vinb7/pulsed_laser_intensity_stabilization/AOM/aom_explanation.png

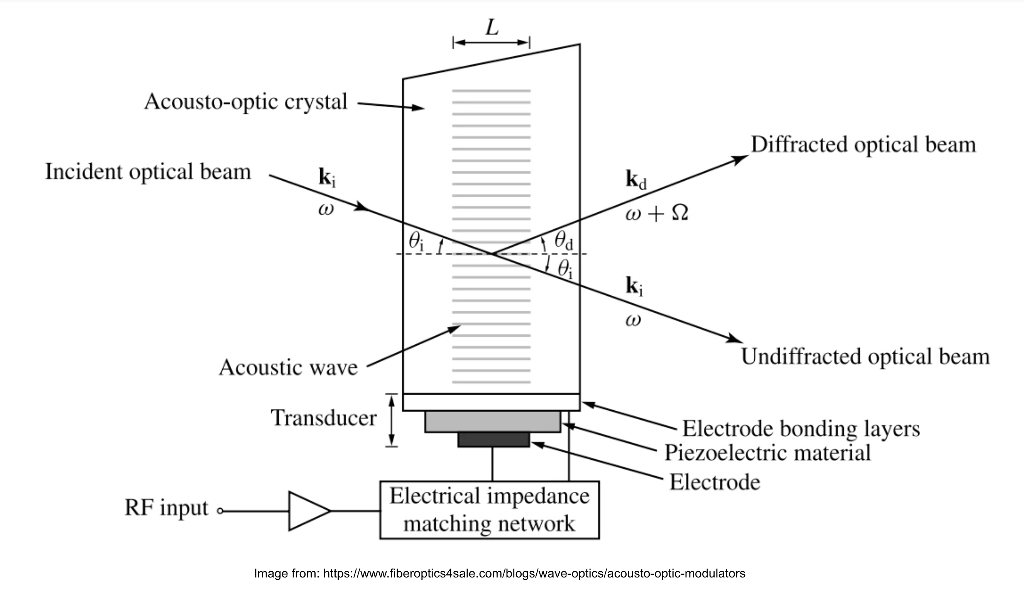
AOM/aom_explanation.png
