vinb7/pulsed_laser_intensity_stabilization/AOM/aom_fig.png

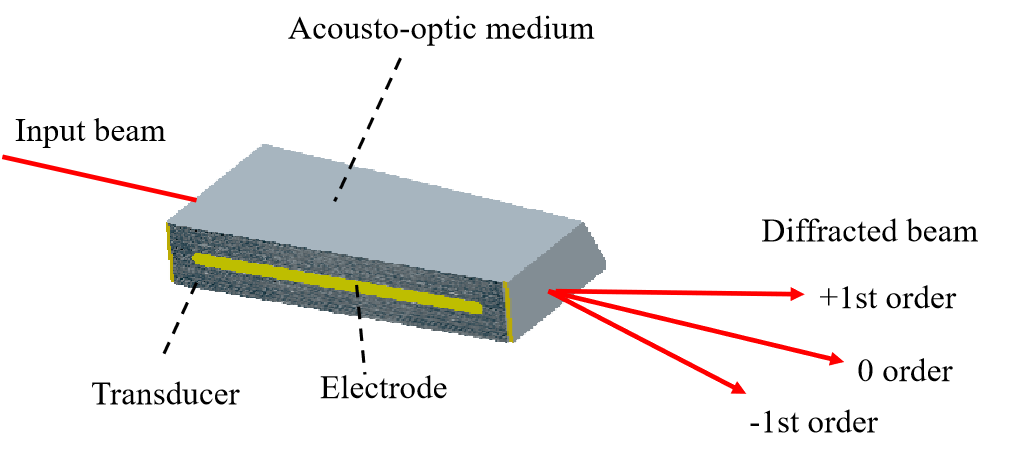
AOM/aom_fig.png
