vinb7/pulsed_laser_intensity_stabilization/data/100kHz/P-100_diabatic.png

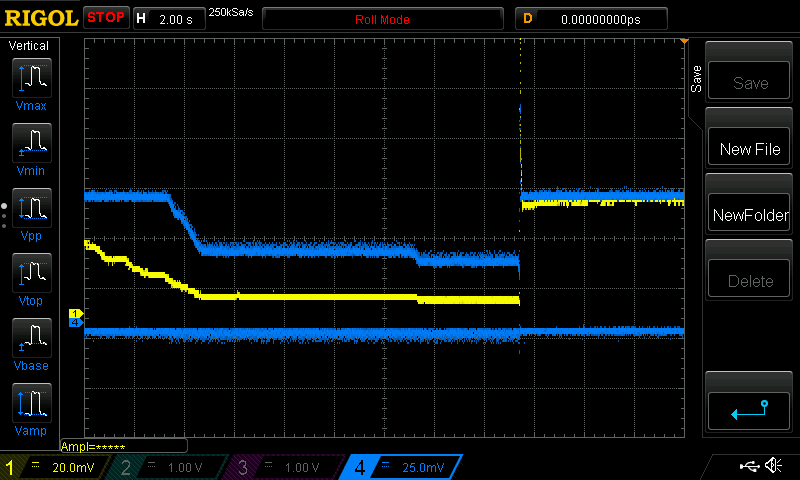
data/100kHz/P-100_diabatic.png
