vinb7/pulsed_laser_intensity_stabilization/data/997.3kHz/P-5+D-0.1.png

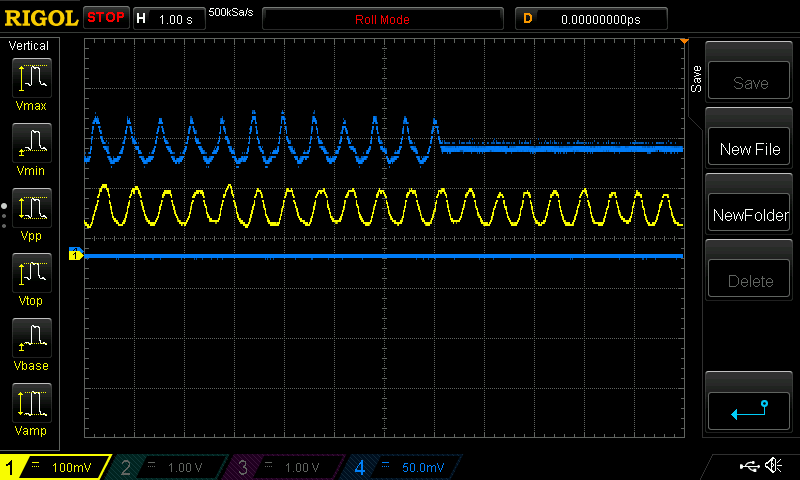
data/997.3kHz/P-5+D-0.1.png
