vinb7/pulsed_laser_intensity_stabilization/data/997.3kHz/P-10_diabatic.png

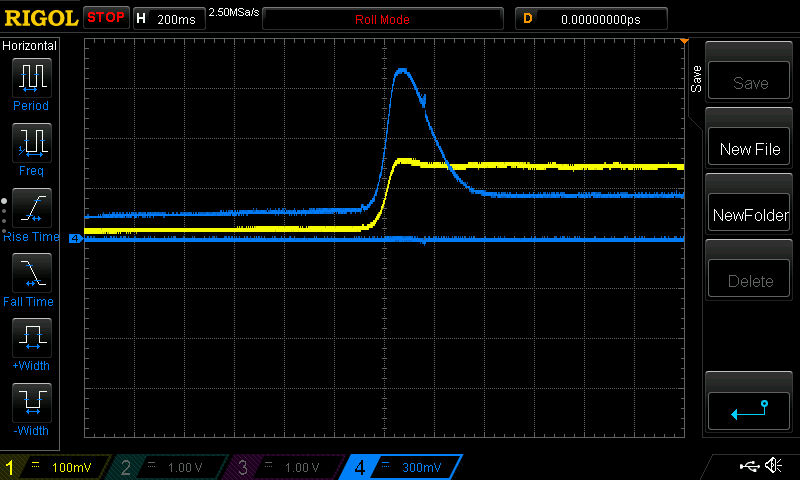
data/997.3kHz/P-10_diabatic.png
