vinb7/pulsed_laser_intensity_stabilization/data/997.3kHz/P-100_deadtime.png

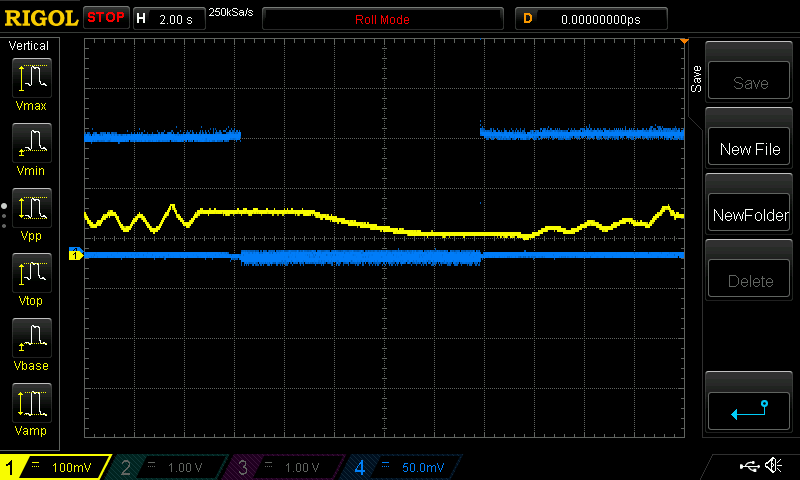
data/997.3kHz/P-100_deadtime.png
