vinb7/pulsed_laser_intensity_stabilization/data/997.3kHz/P-100strong.png

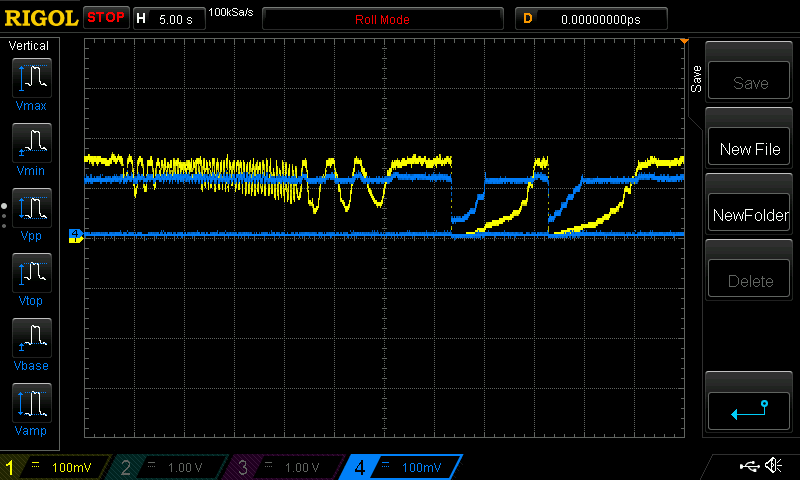
data/997.3kHz/P-100strong.png
