vinb7/pulsed_laser_intensity_stabilization/data/997.3kHz/short_term_stabilization.png

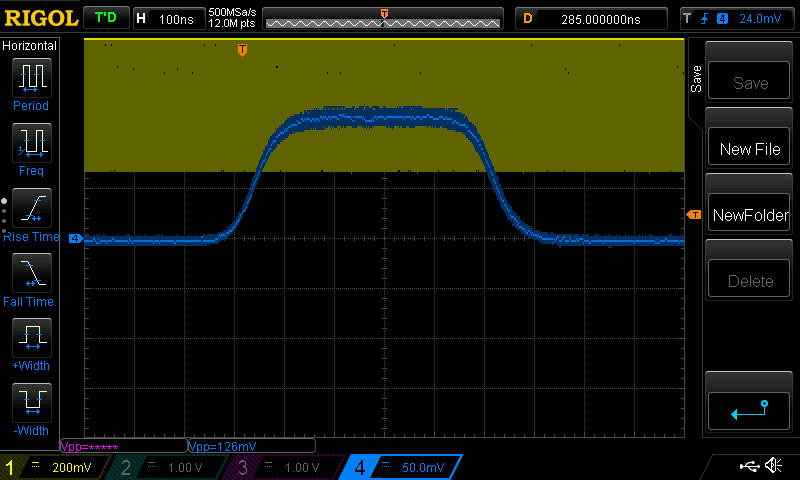
data/997.3kHz/short_term_stabilization.png
