vinb7/pulsed_laser_intensity_stabilization/results/peak fluctuation.png

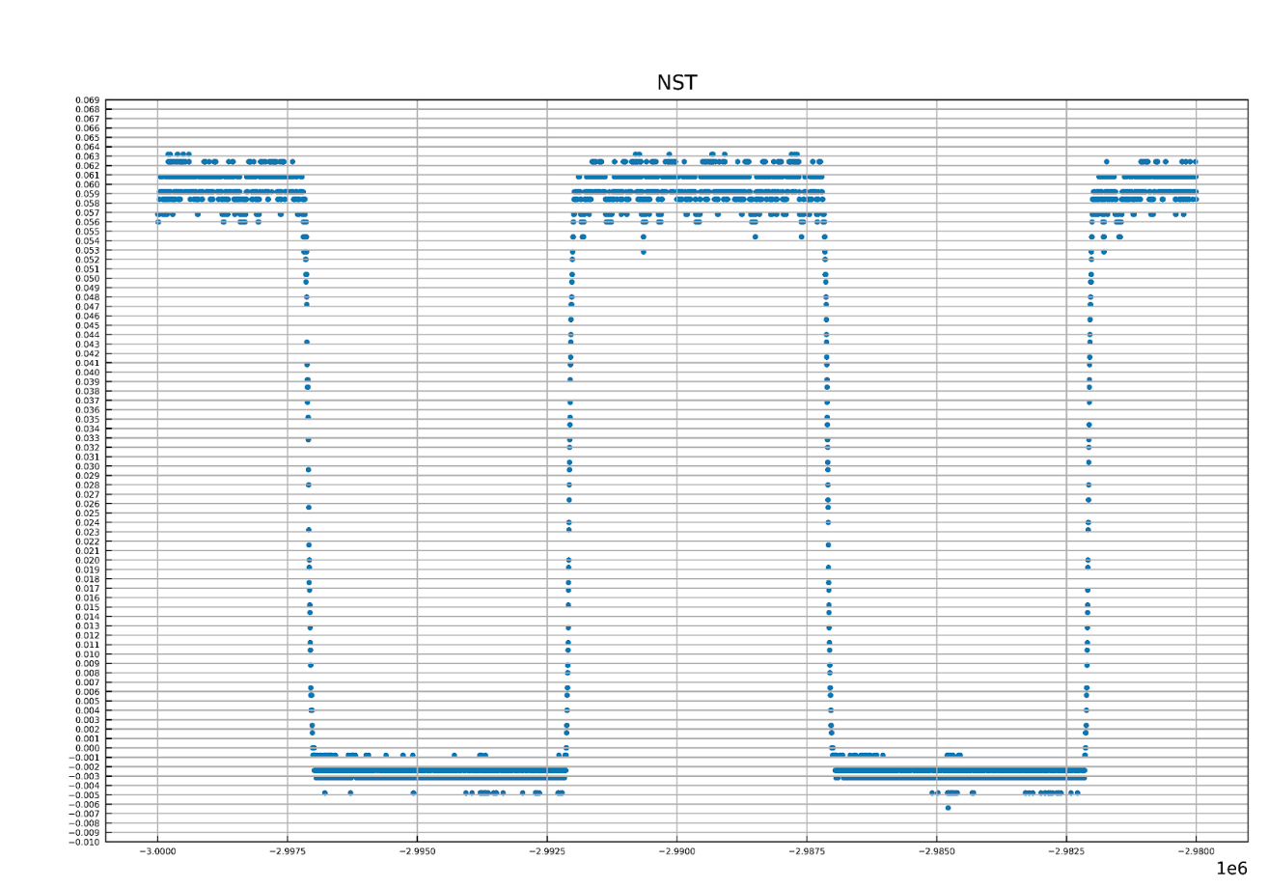
results/peak fluctuation.png
